Talw3g/rpi_power_board/Board/RPi2.DXF

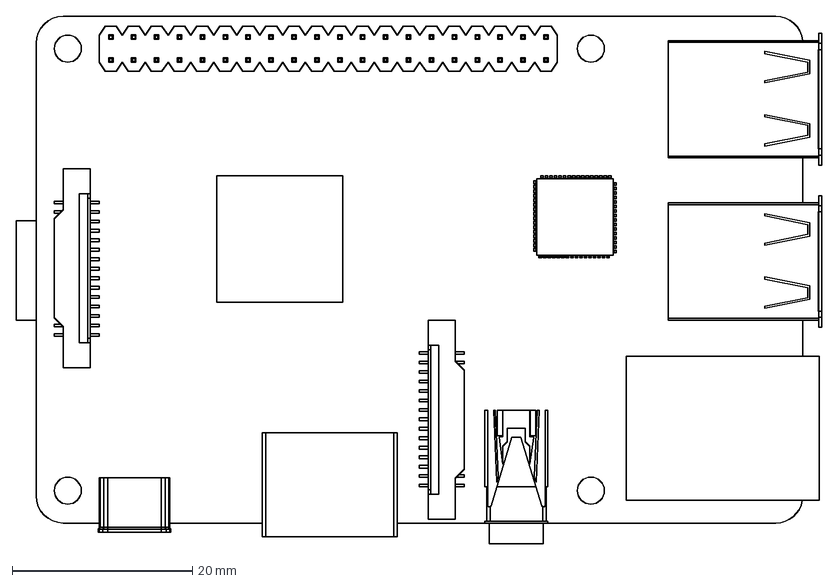
[picture p1: CAD file, 2018-10-30]
Board/RPi2.DXF
89.3 x 58.5 mm
