Talw3g/rpi_power_board/Board/rpi_power.kicad_pcb

## KiCad design Board/rpi_power.kicad_pcb (2018-12-18)

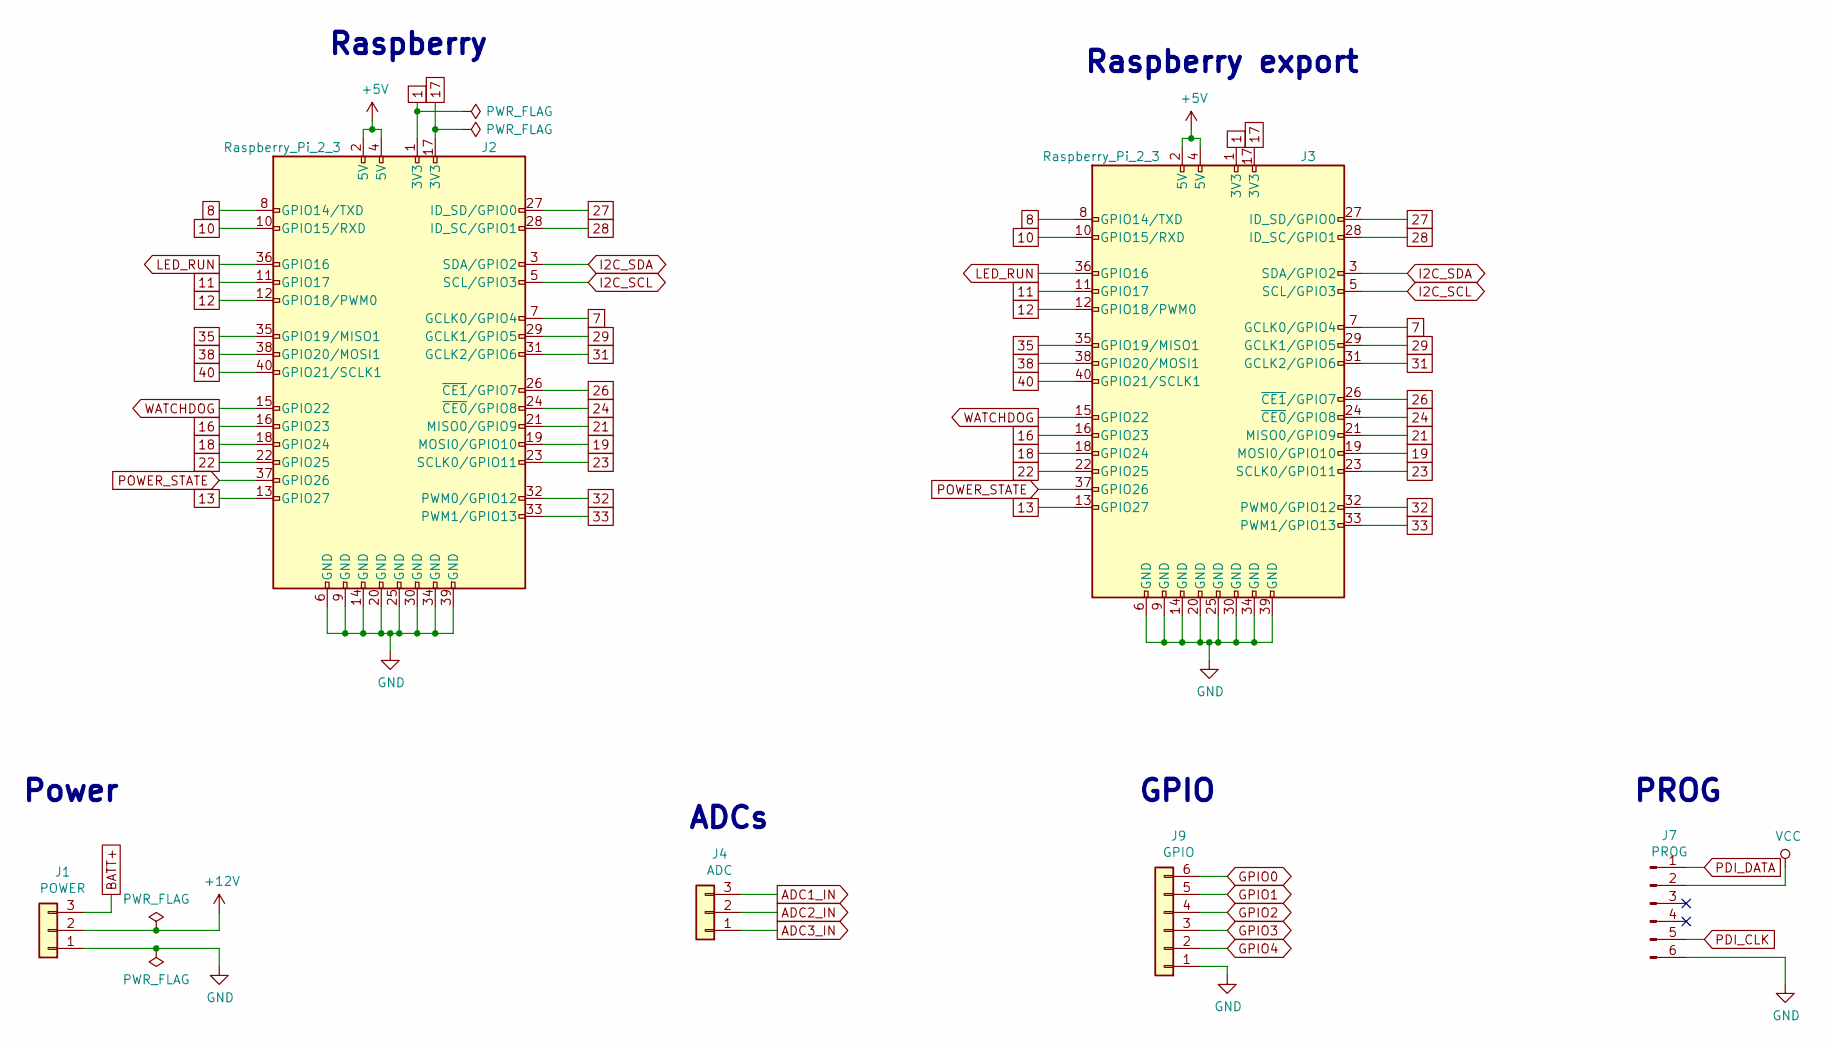
[picture p2: schematic Connectors.sch]

Parts:
J1: POWER; mpt_0,5-3-2,54; Farnell 3041360
J2: Raspberry_Pi_2_3; PinSocket_2x20_P2.54mm_Vertical_SMD; Farnell 2847933
J3: Raspberry_Pi_2_3; PinHeader_2x20_P2.54mm_Vertical_SMD; Farnell 2751390
J4: ADC; mpt_0,5-3-2,54; Farnell 3041360
J7: PROG; PinHeader_2x03_P2.54mm_Vertical_w_enclosure
J9: GPIO; mpt_0,5-6-2,54; Farnell 3041426

Connections:
1: J2.1 (3V3), J3.1 (3V3)
7: J2.7 (GCLK0/GPIO4), J3.7 (GCLK0/GPIO4)
8: J2.8 (GPIO14/TXD), J3.8 (GPIO14/TXD)
10: J2.10 (GPIO15/RXD), J3.10 (GPIO15/RXD)
11: J2.11 (GPIO17), J3.11 (GPIO17)
12: J2.12 (GPIO18/PWM0), J3.12 (GPIO18/PWM0)
13: J2.13 (GPIO27), J3.13 (GPIO27)
16: J2.16 (GPIO23), J3.16 (GPIO23)
17: J2.17 (3V3), J3.17 (3V3)
18: J2.18 (GPIO24), J3.18 (GPIO24)
19: J2.19 (MOSI0/GPIO10), J3.19 (MOSI0/GPIO10)
21: J2.21 (MISO0/GPIO9), J3.21 (MISO0/GPIO9)
22: J2.22 (GPIO25), J3.22 (GPIO25)
23: J2.23 (SCLK0/GPIO11), J3.23 (SCLK0/GPIO11)
24: J2.24 (~CE0~/GPIO8), J3.24 (~CE0~/GPIO8)
26: J2.26 (~CE1~/GPIO7), J3.26 (~CE1~/GPIO7)
27: J2.27 (ID_SD/GPIO0), J3.27 (ID_SD/GPIO0)
28: J2.28 (ID_SC/GPIO1), J3.28 (ID_SC/GPIO1)
29: J2.29 (GCLK1/GPIO5), J3.29 (GCLK1/GPIO5)
31: J2.31 (GCLK2/GPIO6), J3.31 (GCLK2/GPIO6)
32: J2.32 (PWM0/GPIO12), J3.32 (PWM0/GPIO12)
33: J2.33 (PWM1/GPIO13), J3.33 (PWM1/GPIO13)
35: J2.35 (GPIO19/MISO1), J3.35 (GPIO19/MISO1)
38: J2.38 (GPIO20/MOSI1), J3.38 (GPIO20/MOSI1)
40: J2.40 (GPIO21/SCLK1), J3.40 (GPIO21/SCLK1)
+5V: J2.2 (5V), J2.4 (5V), J3.2 (5V), J3.4 (5V); also elsewhere on the board
+12V: J1.2; also elsewhere on the board
ADC1_IN: J4.3; also elsewhere on the board
ADC2_IN: J4.2; also elsewhere on the board
ADC3_IN: J4.1; also elsewhere on the board
BATT+: J1.3; also elsewhere on the board
GND: J1.1, J2.6 (GND), J2.9 (GND), J2.14 (GND), J2.20 (GND), J2.25 (GND), J2.30 (GND), J2.34 (GND), J2.39 (GND), J3.6 (GND), J3.9 (GND), J3.14 (GND), J3.20 (GND), J3.25 (GND), J3.30 (GND), J3.34 (GND), J3.39 (GND), J7.6, J9.1; also elsewhere on the board
GPIO0: J9.6; also elsewhere on the board
GPIO1: J9.5; also elsewhere on the board
GPIO2: J9.4; also elsewhere on the board
GPIO3: J9.3; also elsewhere on the board
GPIO4: J9.2; also elsewhere on the board
I2C_SCL: J2.5 (SCL/GPIO3), J3.5 (SCL/GPIO3); also elsewhere on the board
I2C_SDA: J2.3 (SDA/GPIO2), J3.3 (SDA/GPIO2); also elsewhere on the board
LED_RUN: J2.36 (GPIO16), J3.36 (GPIO16); also elsewhere on the board
PDI_CLK: J7.5; also elsewhere on the board
PDI_DATA: J7.1; also elsewhere on the board
POWER_STATE: J2.37 (GPIO26), J3.37 (GPIO26); also elsewhere on the board
VCC: J7.2; also elsewhere on the board
WATCHDOG: J2.15 (GPIO22), J3.15 (GPIO22); also elsewhere on the board

Notes on the sheet:
Raspberry
Power
ADCs
PROG
GPIO
Raspberry export

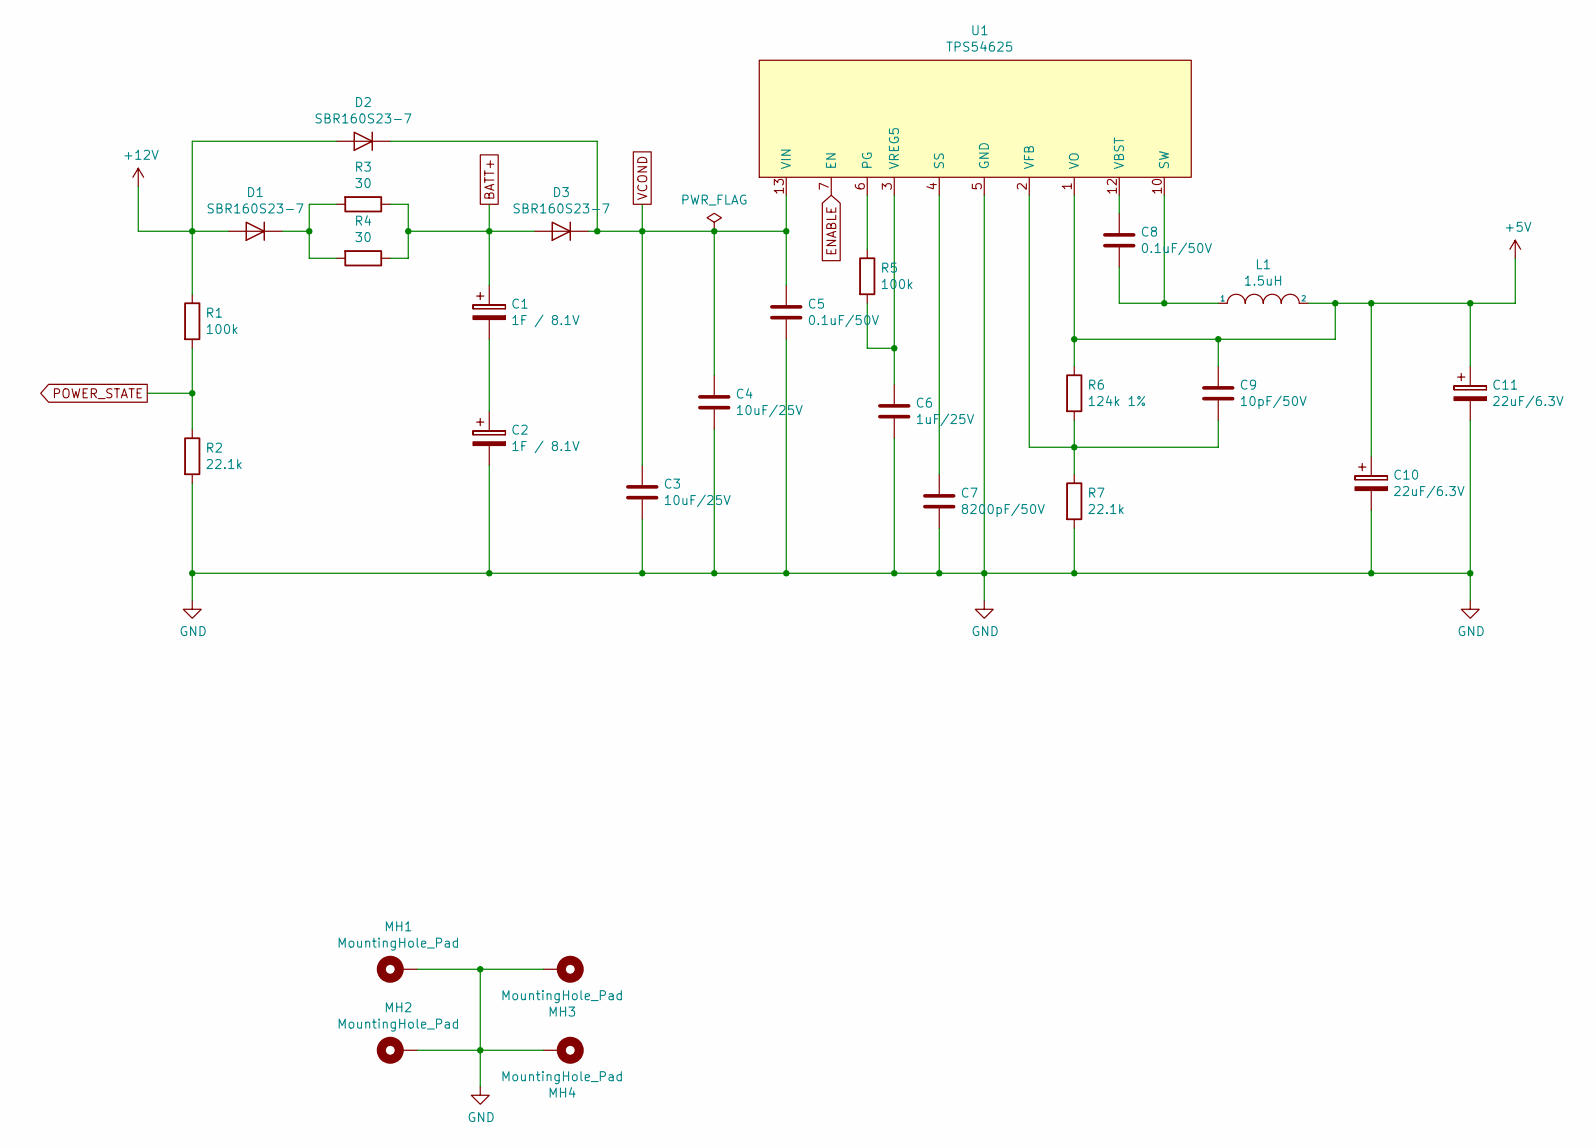
[picture p3: schematic Power.sch]

Parts:
C1, C2: 1F / 8.1V; SCMR22J105SRBA0_vertical; Farnell 2856949
C3, C4: 10uF/25V; C_0805_2012Metric_Pad1.15x1.40mm_HandSolder
C5, C8: 0.1uF/50V; C_0603_1608Metric_Pad1.05x0.95mm_HandSolder
C6: 1uF/25V; C_0805_2012Metric_Pad1.15x1.40mm_HandSolder
C7: 8200pF/50V; C_0603_1608Metric_Pad1.05x0.95mm_HandSolder
C9: 10pF/50V; C_0603_1608Metric_Pad1.05x0.95mm_HandSolder
C10, C11: 22uF/6.3V; Tantalum_SMD_3216_KEMET_T491_HandSolder; Farnell 2321204
D1, D2, D3: SBR160S23-7; D_SOT-23_ANK; Farnell 1863724
L1: 1.5uH; L_7.1x6.5_H3; Farnell 2215610
MH1, MH2, MH3, MH4: MountingHole_Pad; MountingHole_M3-5.8_Pad_Via
R1, R5: 100k; R_0603_1608Metric_Pad1.05x0.95mm_HandSolder
R2, R7: 22.1k; R_0603_1608Metric_Pad1.05x0.95mm_HandSolder
R3, R4: 30; TE_SM5; Farnell 2331667
R6: 124k 1%; R_0603_1608Metric_Pad1.05x0.95mm_HandSolder
U1: TPS54625; HTSSOP-14-PWP_Handsolder; Farnell 2361244

Connections:
+5V: C9.1, C10.1, C11.1, L1.2, R6.1, U1.1 (VO); also elsewhere on the board
+12V: D1.2 (A), D2.2 (A), R1.1; also elsewhere on the board
BATT+: C1.1, D3.2 (A), R3.1, R4.1; also elsewhere on the board
ENABLE: U1.7 (EN); also elsewhere on the board
GND: C2.2, C3.2, C4.2, C5.2, C6.2, C7.2, C10.2, C11.2, MH1.1, MH2.1, MH3.1, MH4.1, R2.2, R7.2, U1.5 (GND), U1.8 (GND), U1.9 (GND), U1.15 (GND); also elsewhere on the board
unnamed: C1.2, C2.1
unnamed: C6.1, R5.2, U1.3 (VREG5)
unnamed: C7.1, U1.4 (SS)
unnamed: C8.1, U1.12 (VBST)
unnamed: C8.2, L1.1, U1.10 (SW), U1.11 (SW)
unnamed: C9.2, R6.2, R7.1, U1.2 (VFB)
unnamed: D1.1 (K), R3.2, R4.2
unnamed: R5.1, U1.6 (PG)
POWER_STATE: R1.2, R2.1; also elsewhere on the board
VCOND: C3.1, C4.1, C5.1, D2.1 (K), D3.1 (K), U1.13 (VIN), U1.14 (VIN); also elsewhere on the board

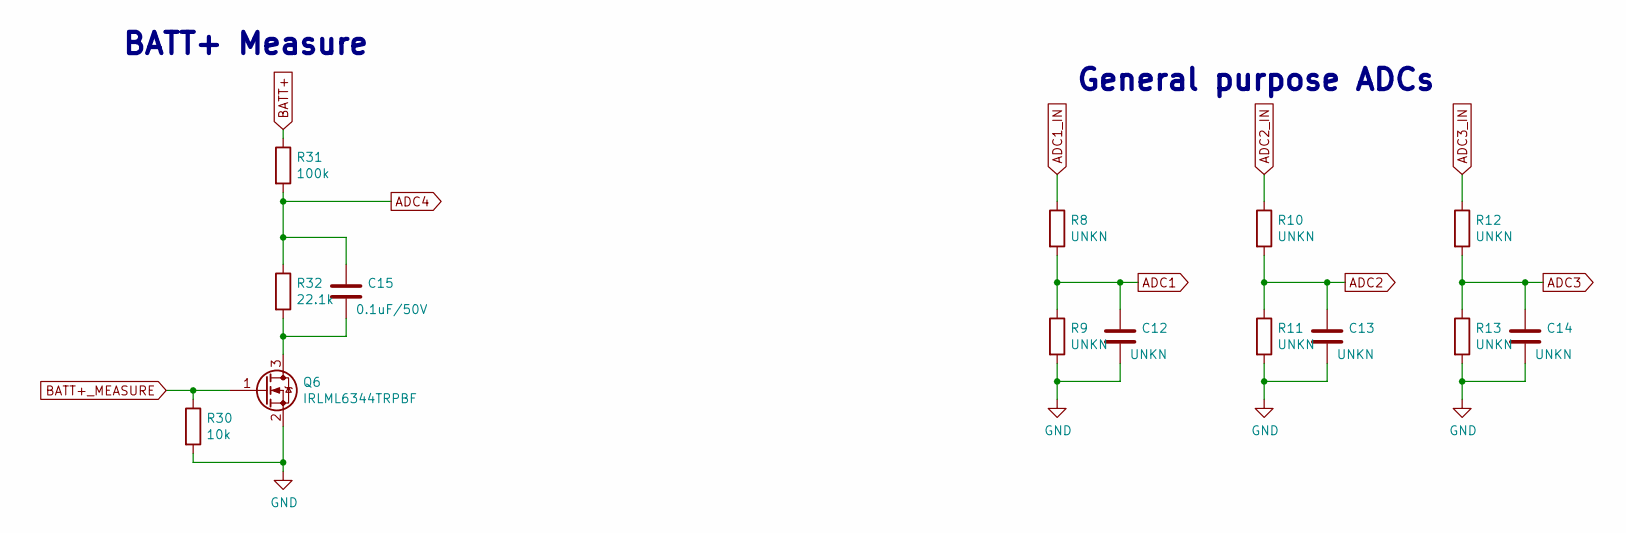
[picture p4: schematic Sensors.sch]

Parts:
C12, C13, C14: UNKN; C_0603_1608Metric_Pad1.05x0.95mm_HandSolder
C15: 0.1uF/50V; C_0603_1608Metric_Pad1.05x0.95mm_HandSolder
Q6: IRLML6344TRPBF; SOT-23_Handsoldering; Farnell IRLML6344TRPBF
R8, R9, R10, R11, R12, R13: UNKN; R_0603_1608Metric_Pad1.05x0.95mm_HandSolder
R30: 10k; R_0603_1608Metric_Pad1.05x0.95mm_HandSolder
R31: 100k; R_0603_1608Metric_Pad1.05x0.95mm_HandSolder
R32: 22.1k; R_0603_1608Metric_Pad1.05x0.95mm_HandSolder

Connections:
ADC1: C12.1, R8.2, R9.1; also elsewhere on the board
ADC1_IN: R8.1; also elsewhere on the board
ADC2: C13.1, R10.2, R11.1; also elsewhere on the board
ADC2_IN: R10.1; also elsewhere on the board
ADC3: C14.1, R12.2, R13.1; also elsewhere on the board
ADC3_IN: R12.1; also elsewhere on the board
ADC4: C15.1, R31.2, R32.1; also elsewhere on the board
BATT+: R31.1; also elsewhere on the board
BATT+_MEASURE: Q6.1 (G), R30.1; also elsewhere on the board
GND: C12.2, C13.2, C14.2, Q6.2 (S), R9.2, R11.2, R13.2, R30.2; also elsewhere on the board
unnamed: C15.2, Q6.3 (D), R32.2

Notes on the sheet:
BATT+ Measure
General purpose ADCs

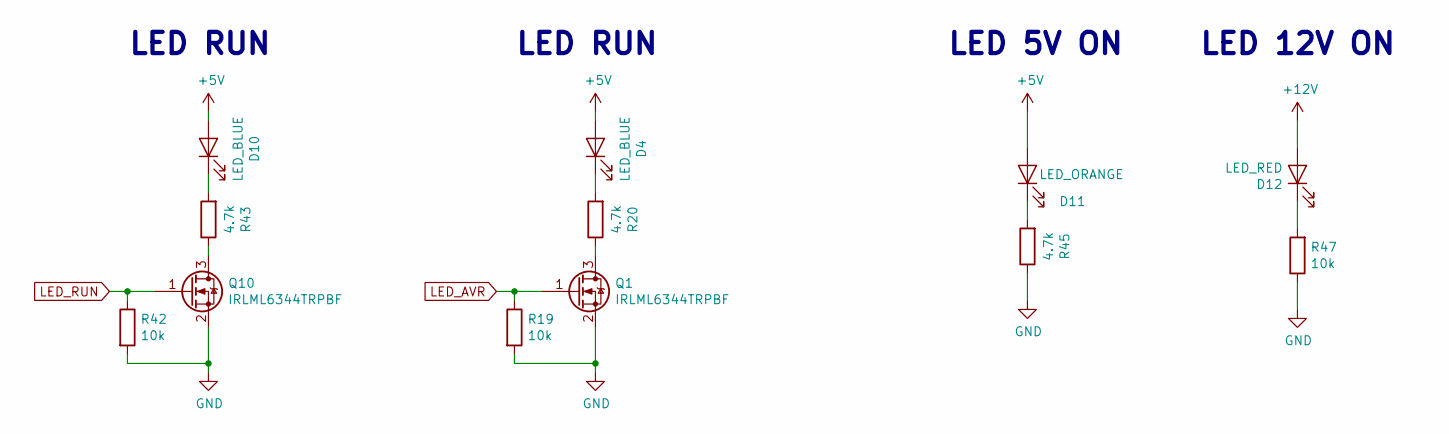
[picture p5: schematic LED.sch]

Parts:
D4, D10: LED_BLUE; LED_0603_1608Metric_Pad1.05x0.95mm_HandSolder; Farnell 2251459
D11: LED_ORANGE; LED_0603_1608Metric_Pad1.05x0.95mm_HandSolder; Farnell 2251473
D12: LED_RED; LED_0603_1608Metric_Pad1.05x0.95mm_HandSolder; Farnell 2251484
Q1, Q10: IRLML6344TRPBF; SOT-23_Handsoldering; Farnell IRLML6344TRPBF
R19, R42, R47: 10k; R_0603_1608Metric_Pad1.05x0.95mm_HandSolder
R20, R43, R45: 4.7k; R_0603_1608Metric_Pad1.05x0.95mm_HandSolder

Connections:
+5V: D4.2 (A), D10.2 (A), D11.2 (A); also elsewhere on the board
+12V: D12.2 (A); also elsewhere on the board
GND: Q1.2 (S), Q10.2 (S), R19.2, R42.2, R45.1, R47.1; also elsewhere on the board
LED_AVR: Q1.1 (G), R19.1; also elsewhere on the board
LED_RUN: Q10.1 (G), R42.1; also elsewhere on the board
unnamed: D4.1 (K), R20.2
unnamed: D10.1 (K), R43.2
unnamed: D11.1 (K), R45.2
unnamed: D12.1 (K), R47.2
unnamed: Q1.3 (D), R20.1
unnamed: Q10.3 (D), R43.1

Notes on the sheet:
LED RUN
LED 5V ON
LED 12V ON

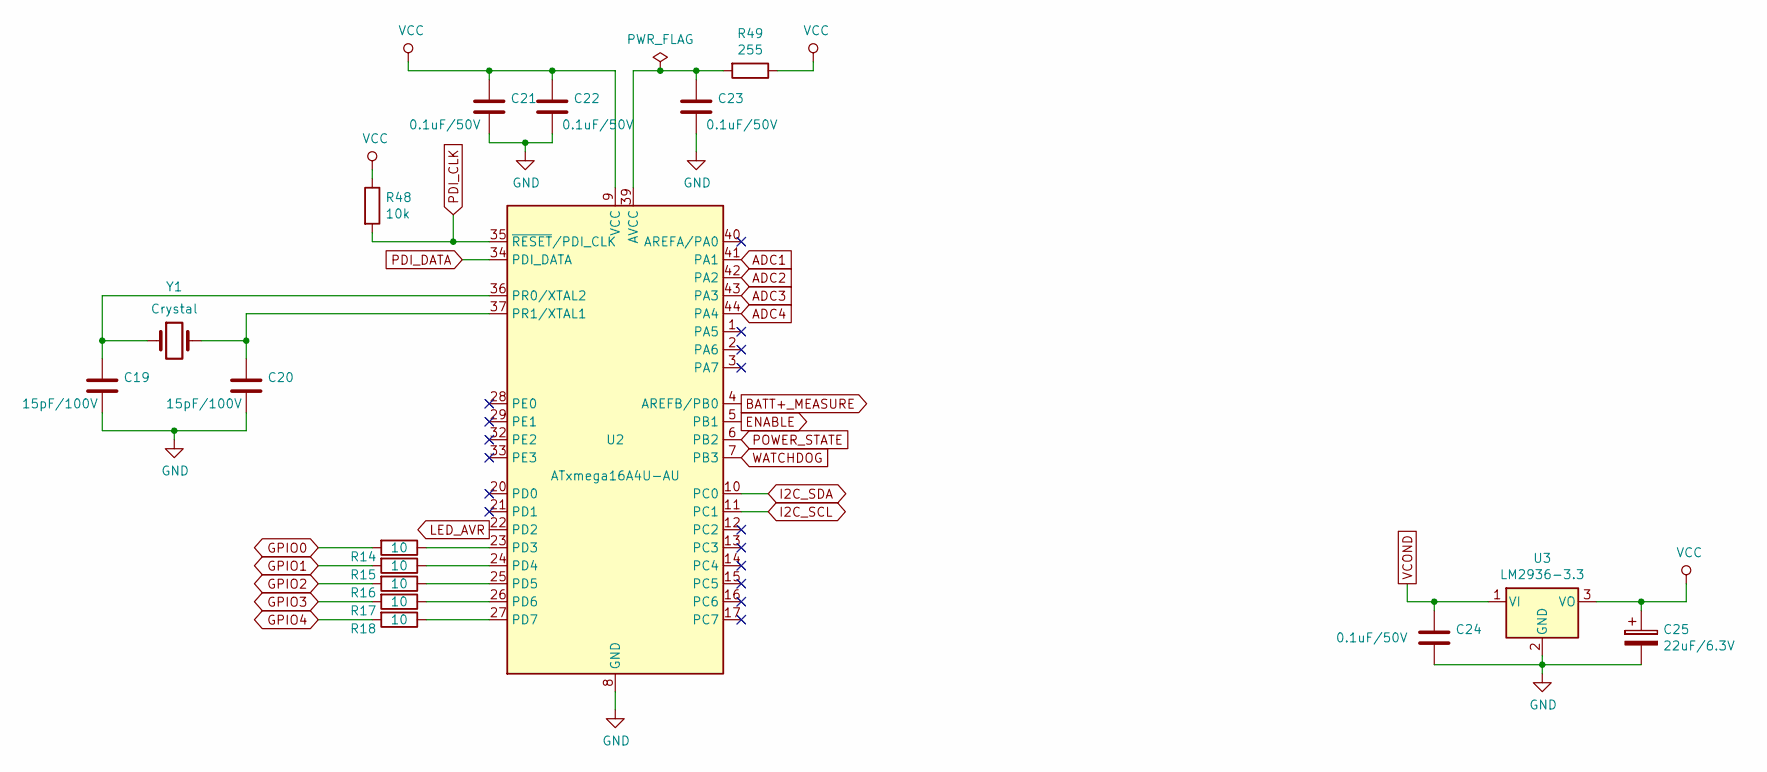
[picture p6: schematic Microcontroller.sch]

Parts:
C19, C20: 15pF/100V; C_0603_1608Metric_Pad1.05x0.95mm_HandSolder
C21, C22, C23, C24: 0.1uF/50V; C_0603_1608Metric_Pad1.05x0.95mm_HandSolder
C25: 22uF/6.3V; Tantalum_SMD_3216_KEMET_T491_HandSolder; Farnell 2321204
R14, R15, R16, R17, R18: 10; R_0603_1608Metric_Pad1.05x0.95mm_HandSolder
R48: 10k; R_0603_1608Metric_Pad1.05x0.95mm_HandSolder
R49: 255; R_0603_1608Metric_Pad1.05x0.95mm_HandSolder
U2: ATxmega16A4U-AU; TQFP-44_10x10mm_P0.8mm; Farnell 2066301
U3: LM2936-3.3; SOT-223; Farnell 1469062
Y1: Crystal; Crystal_SMD_Abracon_ABM3-2Pin_5.0x3.2mm; Farnell 2467791

Connections:
ADC1: U2.41 (PA1); also elsewhere on the board
ADC2: U2.42 (PA2); also elsewhere on the board
ADC3: U2.43 (PA3); also elsewhere on the board
ADC4: U2.44 (PA4); also elsewhere on the board
BATT+_MEASURE: U2.4 (AREFB/PB0); also elsewhere on the board
ENABLE: U2.5 (PB1); also elsewhere on the board
GND: C19.2, C20.2, C21.2, C22.2, C23.2, C24.2, C25.2, U2.8 (GND), U2.18 (GND), U2.30 (GND), U2.38 (GND), U3.2 (GND), U3.4; also elsewhere on the board
GPIO0: R14.2; also elsewhere on the board
GPIO1: R15.2; also elsewhere on the board
GPIO2: R16.2; also elsewhere on the board
GPIO3: R17.2; also elsewhere on the board
GPIO4: R18.2; also elsewhere on the board
I2C_SCL: U2.11 (PC1); also elsewhere on the board
I2C_SDA: U2.10 (PC0); also elsewhere on the board
LED_AVR: U2.22 (PD2); also elsewhere on the board
unnamed: C19.1, U2.36 (PR0/XTAL2), Y1.1
unnamed: C20.1, U2.37 (PR1/XTAL1), Y1.2
unnamed: C23.1, R49.2, U2.39 (AVCC)
unnamed: R14.1, U2.23 (PD3)
unnamed: R15.1, U2.24 (PD4)
unnamed: R16.1, U2.25 (PD5)
unnamed: R17.1, U2.26 (PD6)
unnamed: R18.1, U2.27 (PD7)
PDI_CLK: R48.2, U2.35 (~RESET~/PDI_CLK); also elsewhere on the board
PDI_DATA: U2.34 (PDI_DATA); also elsewhere on the board
POWER_STATE: U2.6 (PB2); also elsewhere on the board
VCC: C21.1, C22.1, C25.1, R48.1, R49.1, U2.9 (VCC), U2.19 (VCC), U2.31 (VCC), U3.3 (VO); also elsewhere on the board
VCOND: C24.1, U3.1 (VI); also elsewhere on the board
WATCHDOG: U2.7 (PB3); also elsewhere on the board

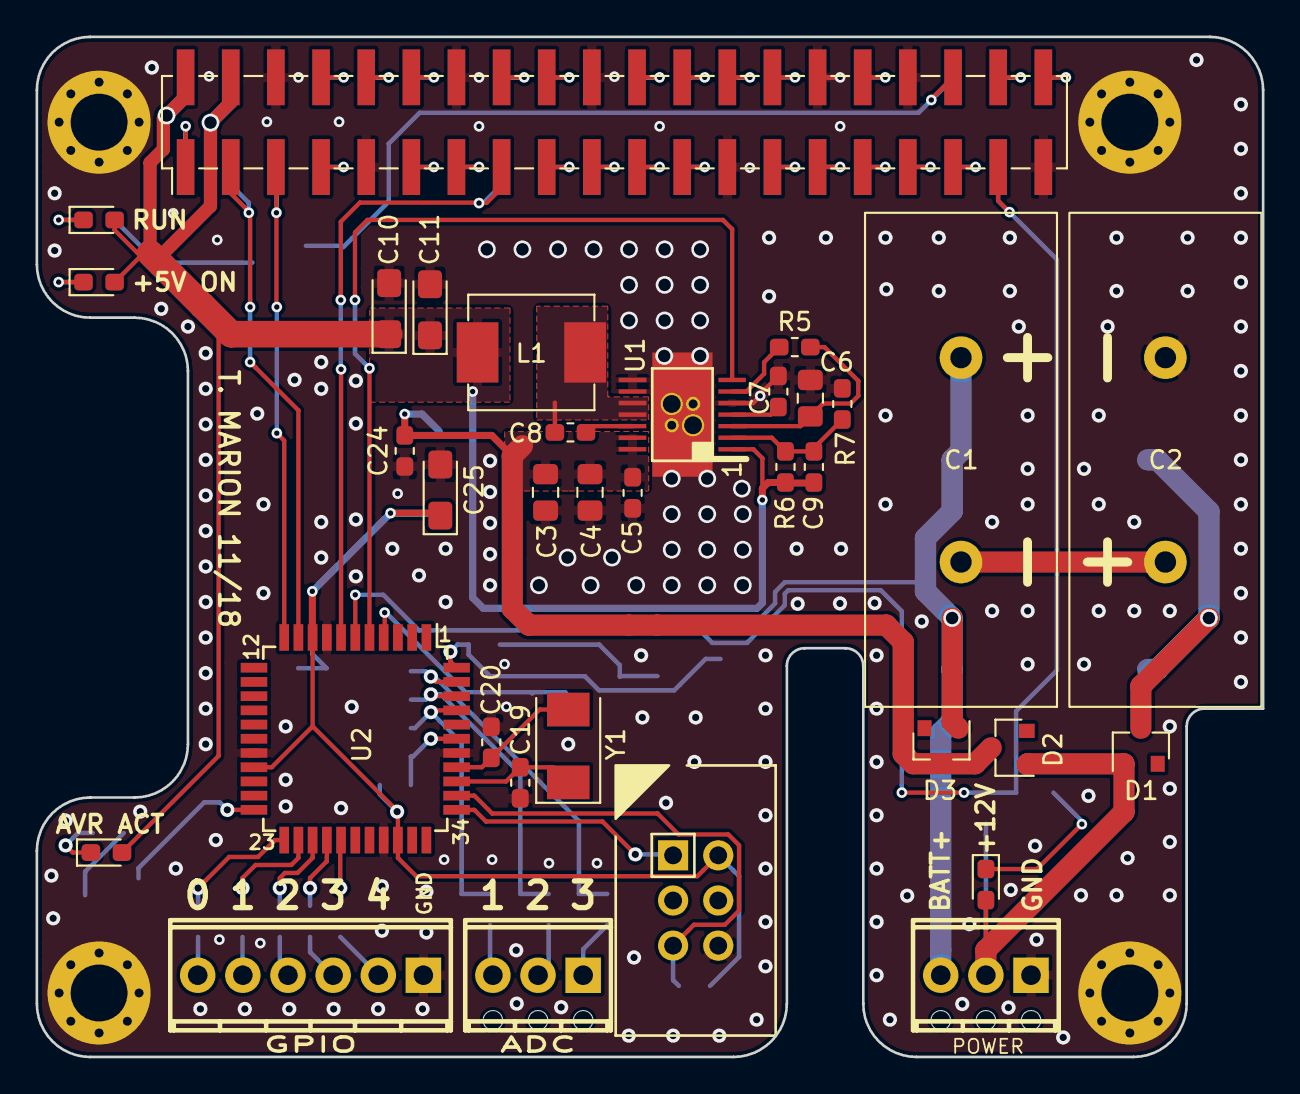
[picture p7: board rpi_power.kicad_pcb from above]

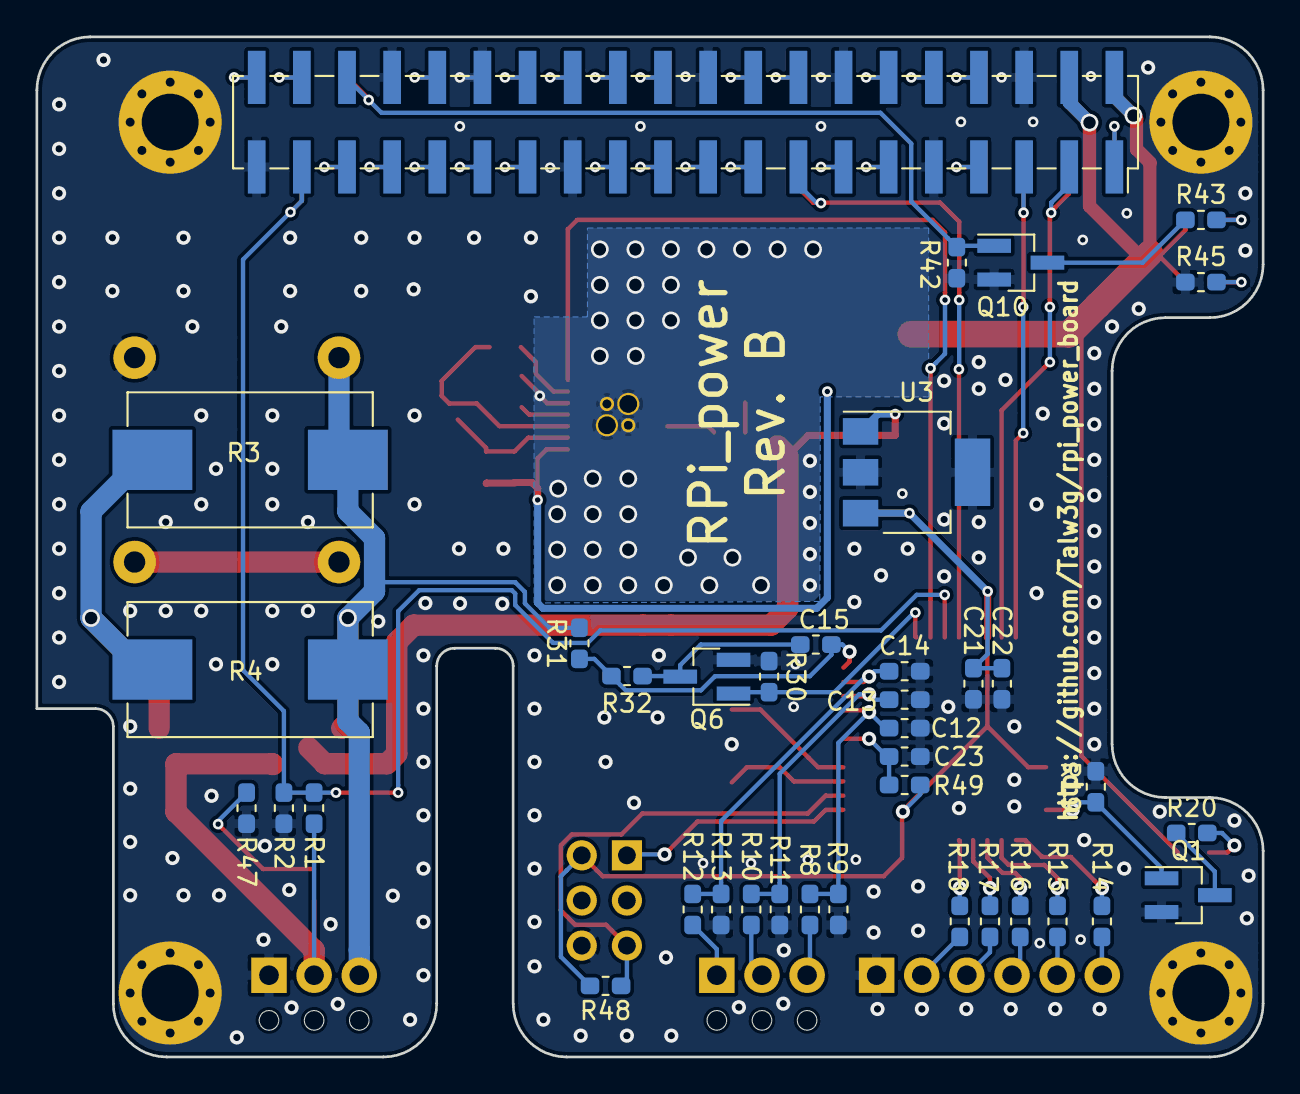
[picture p8: board rpi_power.kicad_pcb from below]

Board: 2 copper layers, 69.0 x 57.4 mm, 76 parts (38 on the bottom side), 76 nets.
