Talw3g/rpi_power_board/Software/src/timer_config.h

/** @addtogroup timer */
//@{
/** @file
 * @brief Timer configuration
 */
/** @name Configuration
 *
 * Unless otherwise noted, timer configuration values can be defined globally
 * (\c TIMER_* prefix) or specifically for each TIMERxn (\c TIMERxn_* prefix).
 *
 * Timers must be explicitly enabled by defining \ref TIMERxn_ENABLED.
 */
//@{

/** @brief Timer prescaler factor
 *
 * This value directly affects the tick period.
 *
 * Valid values are 1, 2, 4, 8, 64, 256 and 1024.
 */
#define TIMER_PRESCALER_DIV       64

/// Enable TIMERxn
#define TIMERE0_ENABLED
#define TIMERC1_ENABLED


/// Timer used for uptime as xn
#define UPTIME_TIMER              E0
/// Timer channel used for uptime
#define UPTIME_TIMER_CHANNEL      'A'

/// Uptime tick period in microseconds
#define UPTIME_TICK_US            10000


#define BATTERY_TIMER             C1
#define BATTERY_TIMER_CHANNEL     'A'
#define BATTERY_TIMER_INTLVL      INTLVL_LO
#define BATTERY_TIMER_PERIOD      1000000

//@}
//@}
