Talw3g/rpi_power_board/(commit log)

2018-10-26 Schematic done, pending review.
    [Connectors.sch, General_purpose.sch, Microcontroller.sch, Outputs.sch, Power.sch, Sensors.sch, Switches.sch, cellar.sch]
2018-10-27 Changed supercap ref, updated some footprints.
    [Power.sch]
2018-10-28 Replaced wirepads by phoenix connectors.
    [Connectors.sch, General_purpose.sch, Microcontroller.sch, Outputs.sch, Power.sch, Sensors.sch, Switches.sch]
2018-10-30 Routing in progress.
    [Connectors.sch, General_purpose.sch, Microcontroller.sch, Outputs.sch, Power.sch, RPi2.DXF, Sensors.sch, Switches.sch]
2018-10-30 Branched from cellar_board repo. Cleaned up unnecessary items.
    [Connectors.sch, General_purpose.sch, LED.sch, Microcontroller.sch, Outputs.sch, Power.sch, RPi2.DXF, Sensors.sch]
2018-10-30 Components placed.
    [Connectors.sch, Microcontroller.sch, Sensors.sch, rpi_power.kicad_pcb]
2018-10-31 Small changes to components positions.
    [rpi_power.kicad_pcb]
2018-10-31 Updated some footprints.
    [Microcontroller.sch, Power.sch, rpi_power.kicad_pcb]
2018-11-01 Routing done, pending review.
    [Connectors.sch, Microcontroller.sch, Power.sch, Sensors.sch, rpi_power.kicad_pcb]
2018-11-01 Routing and silkscreen done.
    [rpi_power.kicad_pcb]
2018-11-02 Differentiated VCOND and BATT+. Routing done.
    [Connectors.sch, Microcontroller.sch, Power.sch, Sensors.sch, rpi_power.kicad_pcb]
2018-11-02 Small tweaks.
    [rpi_power.kicad_pcb]
2018-11-02 Gerber files generated.
    [rpi_power-B.Cu.gbl, rpi_power-B.Mask.gbs, rpi_power-B.SilkS.gbo, rpi_power-Edge.Cuts.gm1, rpi_power-F.Cu.gtl, rpi_power-F.Mask.gts, rpi_power-F.SilkS.gto, rpi_power.drl]
2018-11-02 Forgot to save before commit...
    [rpi_power.kicad_pcb]
2018-11-03 Corrected silkscreen.
    [rpi_power.kicad_pcb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]
2018-11-13 Removed useless "rpi_power" folder.
    [Connectors.sch, LED.sch, Microcontroller.sch, Power.sch, RPi2.DXF, Sensors.sch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]
2018-11-13 Updated some refs.
    [Connectors.sch, Power.sch]
2018-11-16 Minor modifications.
    [Power.sch]
2018-12-09 Moved board files to specific folder.
    [Connectors.sch, LED.sch, Microcontroller.sch, Power.sch, RPi2.DXF, Sensors.sch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]
2018-12-10 Added protection resistors on xmega GPIOs. Corrected prog connector outline.
    [Connectors.sch, LED.sch, Microcontroller.sch, rpi_power.kicad_pcb]
2018-12-11 Draft for power management code.
2018-12-14 Some corrections.
    [Sensors.sch, rpi_power.kicad_pcb]
2018-12-14 MAJOR CORRECTION: moved ADCs to correct port on xmega. Added a LED controlled by the xmega.
    [LED.sch, Microcontroller.sch, Sensors.sch, rpi_power.kicad_pcb]
2018-12-18 WIP on ADC support.
2020-04-20 WIP on battery voltage measure
